joeatbayes/water-flow-injector-feed/injector-switch/injector-switch.ino

// https://github.com/espressif/arduino-esp32/blob/master/libraries/ESP32/examples/GPIO/FunctionalInterrupt/FunctionalInterrupt.ino
// https://community.home-assistant.io/t/calibration-settings-for-yf-b10-pulse-counter/615651/2

#define S3Module_1_1
#define sens2
#ifdef S3Module_1_1
  #define PIN_LED 11
  #define PIN_SENSE_PWR 47
  #define PIN_TXD0 43
  #define PIN_RXD0 44
  #define PIN_TXD0_ENABLE 21
  #define PIN_MOTOR_ENABLE 16
  #define PIN_SDA 17
  #define PIN_SCL 18
  #define PIN_VSDIV 9
  #define PIN_BUP 1
  #define PIN_BDN 2
  #define PIN_BSEL 4
  #define PIN_BEX 5
  #define PIN_WSENSE1 7
  #define PIN_WSENSE2 8
  #define PIN_1WIRE 38
  #define WHITE SH110X_WHITE
  #define touchThreashold 80000
  #define SCREEN_WIDTH 128  // OLED display width, in pixels
  #define SCREEN_HEIGHT 64  // OLED display height, in pixels
  #define OLED_RESET -1     //   QT-PY / XIAO
#endif
#undef USB_SER
#define SERIAL_BAUD 115200
#define SAVE_EVERY_SEC 3600
#define LITER_PER_GAL 3.78541
#include <Preferences.h>
#include <Wire.h>
#include <Adafruit_GFX.h>
#include <Adafruit_SH110X.h>
#include <FS.h>
#include <SPIFFS.h>
/* Uncomment the initialize the I2C address , uncomment only one, If you get a totally blank screen try the other*/
#define i2c_Address 0x3c  //initialize with the I2C addr 0x3C Typically eBay OLED's
//#define i2c_Address 0x3d //initialize with the I2C addr 0x3D Typically Adafruit OLED's
Preferences preferences;
//Adafruit_SSD1306 display;
Adafruit_SH1106G *Display;
double TotLit=0;
double TotLit1=0;
double TotLit2=0;
double LastSaveTotLit1=0;
double LastSaveTotLit2=0;
float MotorStarted=0;
float MotorStopped=0;
unsigned long LastMeterSaveMs = 0;
#define MIN_MOTOR_OFF_SEC 10
#define MIN_MOTOR_ON_SEC 30
unsigned long flowStartedMs=0;
float lpm1=0;
float lpm2=0;

float elapSec(unsigned long startMs, unsigned long stopMs) {
  return (float)(stopMs - startMs) / 1000.0;
}

void setMotorOn() {
  if (!(digitalRead(PIN_MOTOR_ENABLE))) {
    float stopedSec = elapSec(MotorStopped, millis());
    #ifdef USB_SER
      Serial.print("motOnStopedSec="); Serial.println(stopedSec);
    #endif
    if (stopedSec > MIN_MOTOR_OFF_SEC) {
      MotorStarted = millis();
      digitalWrite(PIN_MOTOR_ENABLE, HIGH);
    }
  } else {
    Serial.print("motor already on");
    // force motor to run for 30 seconds after last
    // valid attempt to turn on.
    MotorStarted = millis();
  }
}

void setMotorOff() {
  if (digitalRead(PIN_MOTOR_ENABLE)) {
    float runSec = elapSec(MotorStarted, millis());
    #ifdef USB_SER
      Serial.print("moOffRunSEc="); Serial.println(runSec);
    #endif
    if (runSec > MIN_MOTOR_ON_SEC) {
      MotorStopped = millis();
      digitalWrite(PIN_MOTOR_ENABLE, LOW);
    }
  } else {
    Serial.println("motor already off");
  }
}


float pulsePerSec(unsigned long pulseCnt, float elapSec) {
  if ((pulseCnt < 1) || (elapSec < 0.00001)) {
    return 0.0;
  }
  return (float)pulseCnt / elapSec;
}

float pulsePerSec(unsigned long pulseCnt, unsigned long startMs, unsigned long stopMs) {
  return pulsePerSec(pulseCnt, elapSec(startMs, stopMs));
}

// F = (7.5* Q-4) ± 5%, Q=L/Min, error: ± 5%
float calcLPMGrediaG1Inch(float pulsesPerSec) {  
  float tmp = ((float) pulsesPerSec + 4.0) / 7.5;
  if (tmp < 0.54) {
    return 0;
  } else {
    return tmp;
  }
}
float calcLPMYFB10(float pulsesPerSec) {
  float tmp = ((float) pulsesPerSec + 8.0) / 6.0;
  if (tmp < 1.35) {
    return 0;
  } else {
    return tmp;
  }
}

float netLiterFlow(float literPerMin, float elapSec) {
  return (literPerMin / 60) * elapSec;
}

bool but,bdt,bst,bet;

void bUpTouch() {
  but=true;
  //Serial.println("bup");
}

void bDnTouch() {
  bdt=true;
  //Serial.println("bdn");
}

void bSelTouch() {
  bst=true;
  //Serial.println("bsel");
}

void bExTouch() {
  bet=true;
  //Serial.println("bex");
}

unsigned long s1Cnt = 0;
unsigned long s1LastCalc = 0;
void pulseS1Rise() {
  s1Cnt++;
  //Serial.println("s1r");
}

unsigned long s2Cnt;
unsigned long s2LastCalc = 0;
void pulseS2Rise() {
  s2Cnt++;  
  //Serial.println("s2r");
}



void setup() {
  // put your setup code here, to run once:
  pinMode(PIN_LED, OUTPUT);
  pinMode(PIN_SENSE_PWR, OUTPUT);
  pinMode(PIN_WSENSE1, INPUT);
  pinMode(PIN_WSENSE2, INPUT);
  pinMode(PIN_MOTOR_ENABLE, OUTPUT);
  digitalWrite(PIN_SENSE_PWR, HIGH);
  digitalWrite(PIN_LED, HIGH);
  digitalWrite(PIN_MOTOR_ENABLE, LOW);
  Wire.setTimeout(3000);
  preferences.begin("meter", false);
  delay(40);
  #ifdef USB_SER
  Serial.begin(115200);
  #endif

  Wire.begin(PIN_SDA, PIN_SCL);
  //Wire.setPins(PIN_SDA, PIN_SCL);
  delay(400);
  
  #ifdef USB_SER
    Serial.println("start");
  #endif 

  Display = new Adafruit_SH1106G(SCREEN_WIDTH, SCREEN_HEIGHT, &Wire, OLED_RESET);
  Display->begin(i2c_Address, true);
  
  #ifdef USB_SER
    Serial.println("display init");
  #endif

  Display->display();
  delay(40);
  Display->clearDisplay();
  Display->setTextSize(1);
  Display->setTextColor(WHITE);
  Display->setRotation(0);
  Display->display();
  delay(1000);
  Display->clearDisplay();
  Display->println("Starting");
  Display->display();
  s1LastCalc = millis();
  s2LastCalc = s1LastCalc;
  touchAttachInterrupt(PIN_BUP, bUpTouch, touchThreashold);
  touchAttachInterrupt(PIN_BDN, bDnTouch, touchThreashold);
  touchAttachInterrupt(PIN_BSEL, bSelTouch, touchThreashold);
  touchAttachInterrupt(PIN_BEX, bExTouch, touchThreashold);

  attachInterrupt(digitalPinToInterrupt(PIN_WSENSE1), pulseS1Rise, RISING);
  attachInterrupt(digitalPinToInterrupt(PIN_WSENSE2), pulseS2Rise, RISING); 
  #ifdef USB_SER
     Serial.println("end setup");
  #endif

  TotLit1 = preferences.getDouble("TotLit1",0);
  TotLit2 = preferences.getDouble("TotLit2",0);
  LastSaveTotLit1 = TotLit1;
  LastSaveTotLit2 = TotLit2;
  LastMeterSaveMs = millis();
  // Retreive totalAcumReading from Properties


}



long cnt;
void loop() {
  cnt += 1;
  // put your main code here, to run repeatedly:
  digitalWrite(PIN_LED, !digitalRead(PIN_LED));
  
  delay(1000);
  //Serial.println(cnt);
  //int bur = touchRead(PIN_BUP);
  //int bdr = touchRead(PIN_BDN);
  //int bsr = touchRead(PIN_BSEL);
  //int ber = touchRead(PIN_BEX);
  #ifdef USB_SER
    Serial.printf("bur=%d bdr=%d bsr=%d ber=%d\n", bur, bdr, bsr, ber);
  #endif

  unsigned long currMs = millis();
  #ifdef sens1
    // Take copy of our counters so the ISR can continue  
    disableInterrupt(PIN_WSENSE1);
    
    unsigned long s1CntT = s1Cnt;
    unsigned long s1LastT = s1LastCalc;
    s1Cnt = 0;
    s1LastCalc = millis();
    enableInterrupt(PIN_WSENSE1);
  #endif

  #ifdef sens2
    disableInterrupt(PIN_WSENSE2);
    unsigned long s2CntT = s2Cnt;
    unsigned long s2LastT = s2LastCalc;
    s2Cnt = 0;  
    s2LastCalc = millis();  
    enableInterrupt(PIN_WSENSE2);
  #endif

  #ifdef sens1
  // Now calculate or current flow rate and total liters that have flowed
  float esec1 = elapSec(s1LastT, currMs);
  float ppsec1 = pulsePerSec(s1CntT, esec1);    
  lpm1 = calcLPMGrediaG1Inch(ppsec1);
  float nlit1 = netLiterFlow(lpm1, esec1);
  TotLit1 += nlit1;
  if (ppsec1 > 1) {
    #ifdef USB_SER
      Serial.print("1 cnt="); Serial.print(s1CntT);
      Serial.print(" pps="); Serial.print(ppsec1);  
      Serial.print(" esec="); Serial.print(esec1);
      Serial.print(" lpm="); Serial.print(lpm1);
      Serial.print(" nlit="); Serial.println(nlit1);  
      Serial.print(" tlit="); Serial.println(totLit1);  
    #endif
  }
  #endif

  #ifdef sens2
    float esec2 = elapSec(s2LastT, currMs);
    float ppsec2 = pulsePerSec(s2CntT, esec2);
    lpm2 =  calcLPMGrediaG1Inch(ppsec2);
    float nlit2 = netLiterFlow(lpm2, esec2);
    TotLit2 += nlit2;
    if (ppsec2 > 1) {
      #ifdef USB_SER
        Serial.print("2 cnt="); Serial.print(s2CntT);
        Serial.print(" pps="); Serial.print(ppsec2);  
        Serial.print(" esec="); Serial.print(esec2);
        Serial.print(" lpm="); Serial.print(lpm2);
        Serial.print(" nlit="); Serial.print(nlit2);  
        Serial.print(" tlit="); Serial.println(totLit2);  
      #endif
    }
  #endif

  float lpm = lpm1 + lpm2;

  // If we detect water flowing for more than 15 
  // seconds then turn the motor on.  Otherwise turn
  // the motor off.  We know the G1 can not measure 
  // flows less than about 1GMP accuratly.   We have 
  // also observed occasional noise in the pulses so
  // we want to avoid turning motor on unless water 
  // is flowing enough to ensure it is not a noise pulse.
  if (lpm > 2.5) {  
     if (flowStartedMs == 0) {
        flowStartedMs = millis();        
     } else {
       float elapFlowSec = elapSec(flowStartedMs,millis());
       if (elapFlowSec > 15.0) {
          setMotorOn();
       }
     }
  } else {
    flowStartedMs = 0;
    setMotorOff();
  }

  TotLit = TotLit1 + TotLit2;
  
  //Display->clearDisplay();
  //Display->printf("lpm1=%0.1f  lpm2=%0.2f\n", lpm1,lpm2);
  
  Display->clearDisplay();
  Display->setCursor(0,0);
  Display->setTextSize(2);
  Display->printf("%0.1f\n", TotLit / LITER_PER_GAL);  
  Display->setTextSize(1);
  Display->print("GPM: ");
  Display->printf("%0.1f",(lpm1 + lpm2)/LITER_PER_GAL);
  Display->display();

  // Save our new reading if our save timer changed.
  float sinceSave = elapSec(LastMeterSaveMs, millis());
  if (sinceSave > SAVE_EVERY_SEC) {
    if (LastSaveTotLit1 != TotLit1) {  
      preferences.putDouble("TotLit1", TotLit1);
      LastSaveTotLit1 = TotLit1;
    }

    if (LastSaveTotLit2 != TotLit2) {
      preferences.putDouble("TotLit2", TotLit2);
      LastSaveTotLit2 = TotLit2;
    }
    LastMeterSaveMs = millis();
  }

  #ifdef USB_SER
    //Serial.printf("cnt1=%ld %cnt2=%ld ppsec1=%3.3f ppsec2=%3.3f lpm1=%3.3f lpm2=%3.3f\n", 
    //   (long) s1CntT, (long) s2CntT,ppsec1, ppsec2, lpm1,lpm2);
  #endif
}
