joeatbayes/water-flow-injector-feed/(commit log)

2024-08-08 added #ifdef to avoid serial use. Also added total accumulator and display on LCD of gallons accumulated and GPM. Also added save of accumlator one an hour.
    [arduino.ino]
2024-08-08 changed both sensors to G1
2024-09-07 added delay so injector does not start until water has been flowing for 15 seconds. Also added #ifdef for sens1 and sens2.
